phantranthehuy/NIBP-monitor-oscillometric-using-STM32/Docs/Project_Report/Images/Arterial_Pressure_Waveforms.png

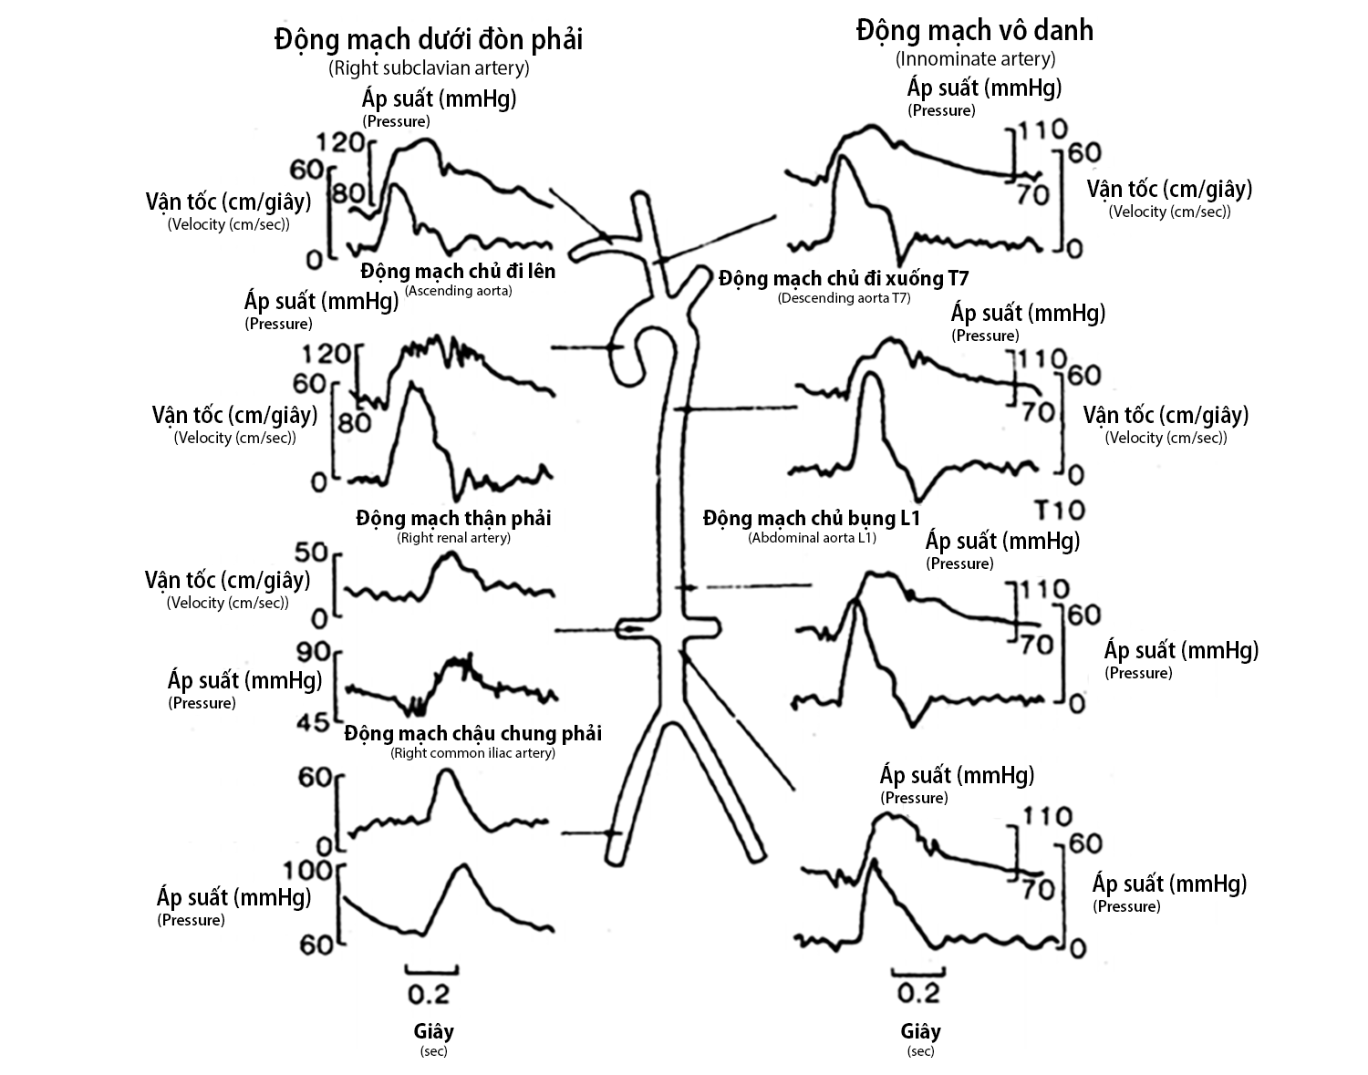
Docs/Project_Report/Images/Arterial_Pressure_Waveforms.png
