phantranthehuy/NIBP-monitor-oscillometric-using-STM32/Docs/Project_Report/Images/Blood_Flow_Velocity_And_Cross_Sectional_Area.png

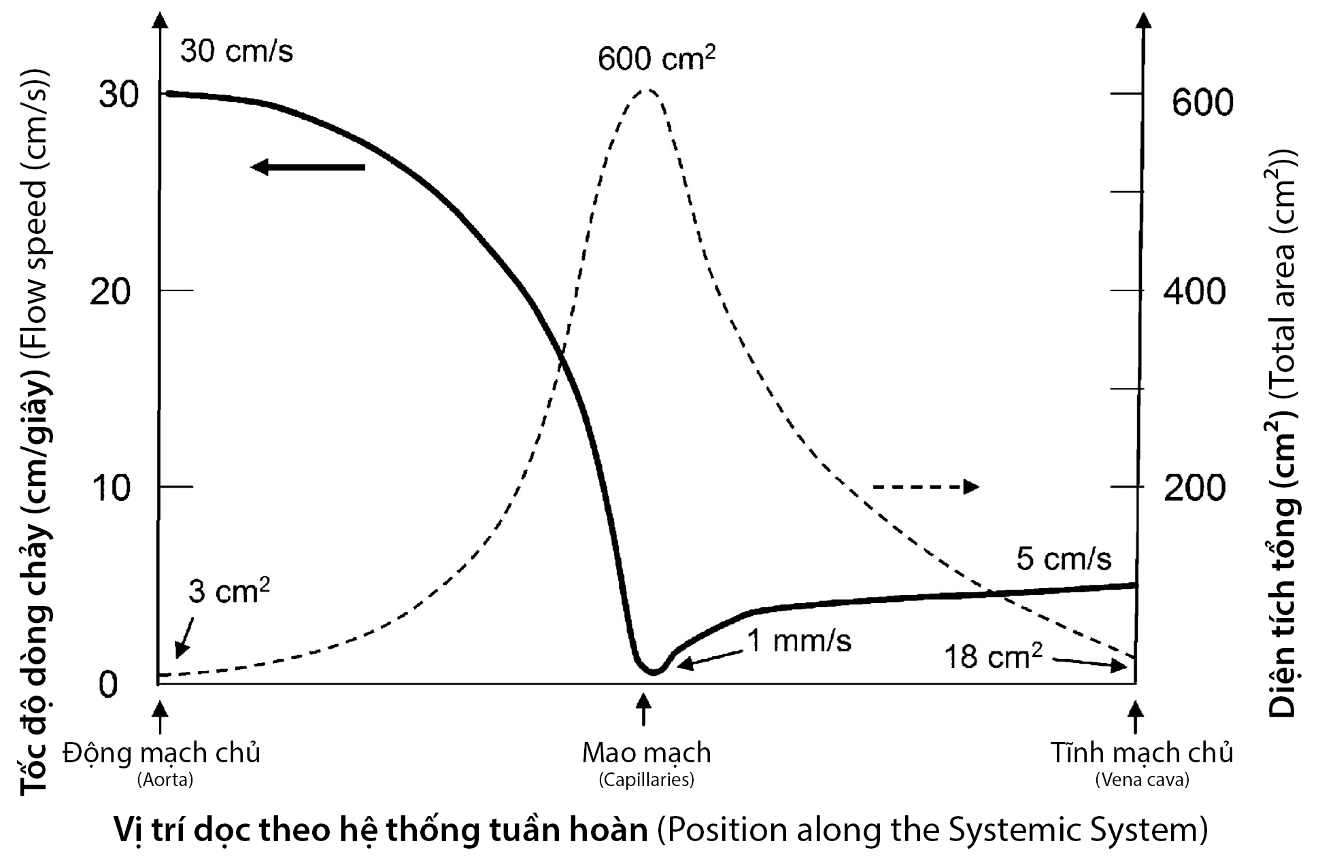
Docs/Project_Report/Images/Blood_Flow_Velocity_And_Cross_Sectional_Area.png
