phantranthehuy/NIBP-monitor-oscillometric-using-STM32/Docs/Project_Report/Images/Circulatory_System_Diagram.png

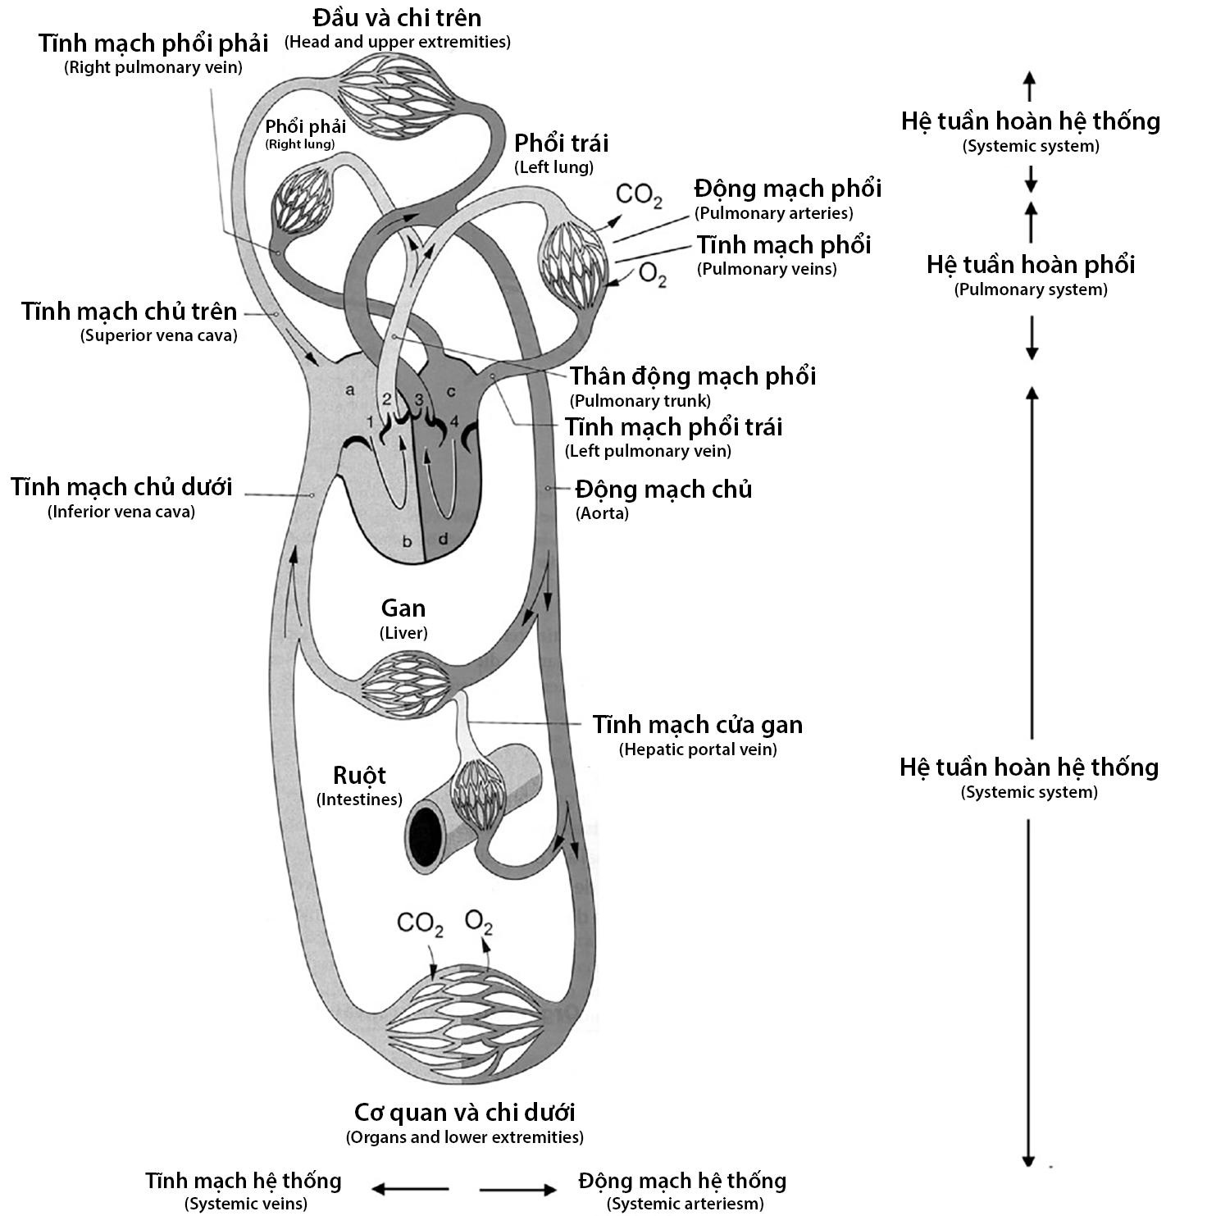
Docs/Project_Report/Images/Circulatory_System_Diagram.png
