phantranthehuy/NIBP-monitor-oscillometric-using-STM32/Docs/Project_Report/Images/Oscillometric_Waveform.png

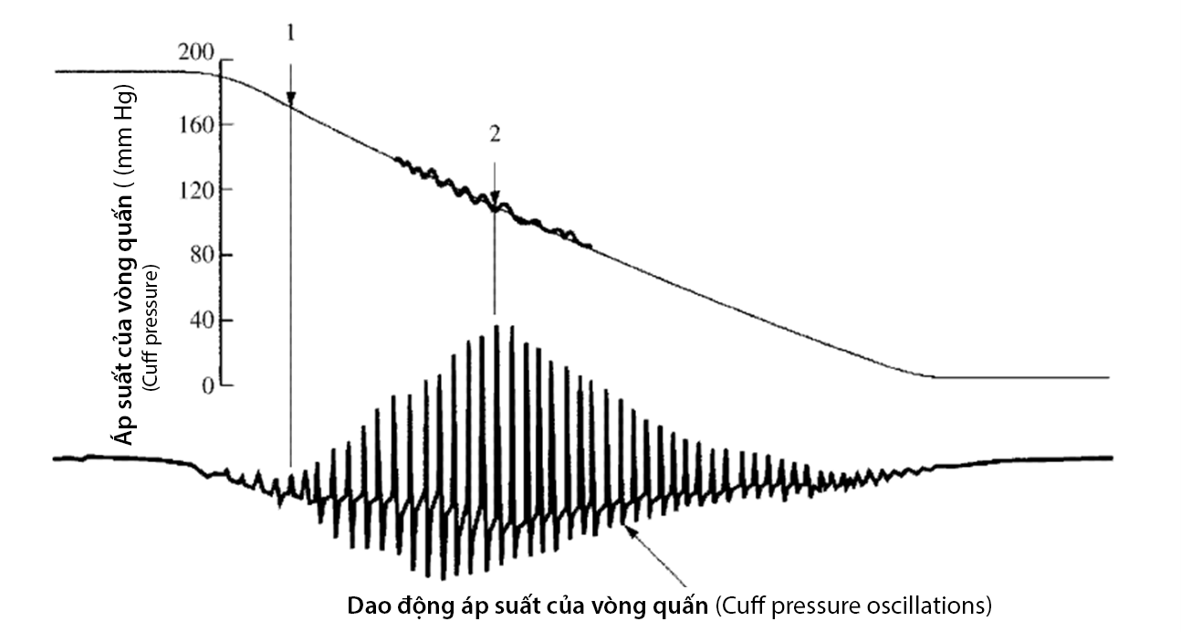
Docs/Project_Report/Images/Oscillometric_Waveform.png
