phantranthehuy/NIBP-monitor-oscillometric-using-STM32/Docs/Project_Report/Images/Venous_Muscle_Pump.png

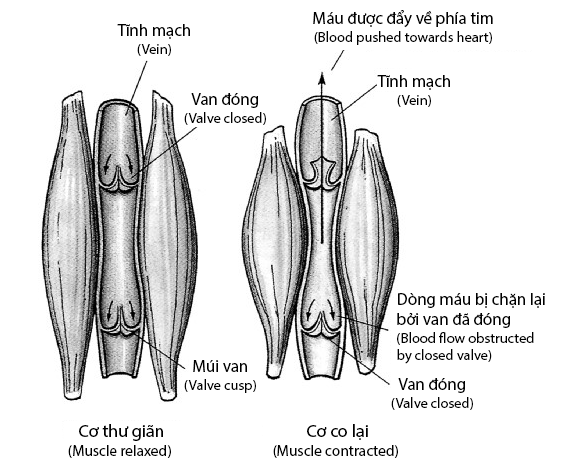
Docs/Project_Report/Images/Venous_Muscle_Pump.png
