phantranthehuy/NIBP-monitor-oscillometric-using-STM32/(list of files, drawings)

Other design files:
Altium/Blood_Pressure_Monitor.PrjPcb
Altium/BPM_Mainboard.PcbDoc
Altium/BPM_Mainboard.SchDoc
