phantranthehuy/NIBP-monitor-oscillometric-using-STM32/Firmware/Core/Src/main.c

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
/* Includes ------------------------------------------------------------------*/
#include "main.h"

ADC_HandleTypeDef hadc1;

I2C_HandleTypeDef hi2c1;

TIM_HandleTypeDef htim2;

/* USER CODE BEGIN PV */
volatile uint8_t timing, timerate, timerun_dias, timecount, timedeflate, timedisplay;
/* USER CODE END PV */

void SystemClock_Config(void);
static void MX_GPIO_Init(void);
static void MX_I2C1_Init(void);
static void MX_ADC1_Init(void);
static void MX_TIM2_Init(void);
/**
  * @brief  The application entry point.
  * @retval int
  */
int main(void)
{
  /* USER CODE BEGIN 1 */
	//define states for Measure control
	//declare variable for motor controls
	uint8_t currentState = 0;
	uint8_t x1, x2 = 0;
	uint8_t timelcd;
	//declare variable for measuring and calculating value
	float DC_gain;
	uint8_t meas_state;
	float  maxpressure, pressure,accum_data, press_data;
	uint8_t count, stop_count;

	//ADC data variables
	float Vref;
	int data;
	float adc_data, former;

	//define counter
	uint8_t sys_count,count_average, countpulse;

	//declare rate measure variable
	float time_pulse,pulse_period, total_pulse_period, pulse_per_min;

	//declare systolic and diastolic variable
	float systolic, diastolic;

	//declare all the threshold values   (giá trị ngưỡng)
	float TH_sys, TH_rate, TH_dias;


  /* USER CODE END 1 */

  /* MCU Configuration--------------------------------------------------------*/

  /* Reset of all peripherals, Initializes the Flash interface and the Systick. */
  HAL_Init();

  /* Configure the system clock */
  SystemClock_Config();

  /* Initialize all configured peripherals */
  MX_GPIO_Init();
  MX_I2C1_Init();
  MX_ADC1_Init();
  MX_TIM2_Init();
  /* USER CODE BEGIN 2 */
  setup(&maxpressure, &meas_state, &former, &TH_sys, &TH_rate,&TH_dias, &time_pulse, &systolic, &diastolic, &total_pulse_period,
  		&pulse_per_min, &sys_count, &count_average,&countpulse, &Vref, &DC_gain, &accum_data, &press_data, &count);
  HAL_ADC_Start(&hadc1);
  HAL_TIM_Base_Start_IT(&htim2);
  /* USER CODE END 2 */

  /* Infinite loop */
  /* USER CODE BEGIN WHILE */
  while (1)
  {
	  switch(currentState)
	      {
	        case startState:
	        	start_state(&sys_count, &pressure, &accum_data, &press_data, &count, &stop_count, &meas_state,
	        		        			&former, &timerun_dias, &time_pulse, &timerate, &timing, &total_pulse_period, &systolic,
	        		        			&diastolic, &pulse_per_min, &count_average, &countpulse, TH_sys, &currentState, &timecount);
	         break;
	        case inflate1State:
	        	inflate1_state(&currentState);
	           break;
	        case inflate2State:
	           inflate2_state();
	           break;
	        case deflateState:
	           deflatestate();
	           break;
	        case displayState:
	           display_state();
	           break;
	        case resetState:
	           reset_state();
	           break;

	     }
    /* USER CODE END WHILE */

    /* USER CODE BEGIN 3 */
  }
  /* USER CODE END 3 */
}

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
/* USER CODE BEGIN 4 */
void HAL_TIM_PeriodElapsedCallback(TIM_HandleTypeDef *htim)
{
	if(HAL_GPIO_ReadPin(GPIOA, GPIO_PIN_7) == GPIO_PIN_RESET)
	{
		x1 = 1;
	}
	if(HAL_GPIO_ReadPin(GPIOA, GPIO_PIN_6) == GPIO_PIN_RESET)
	{
		x1 = 2;
	}
	if(HAL_GPIO_ReadPin(GPIOA, GPIO_PIN_5) == GPIO_PIN_RESET)
	{
		x2 = 1;
	}	//nút stop nhấn, x2 = 1
	timecount++;    // Tăng timecount mỗi lần chạy vòng lặp
	timedeflate++;  // Tăng timedeflate mỗi lần chạy vòng lặp

	// Giảm biến timing mỗi lần qua 1 chu kỳ 40ms
	if(timing > 0) {
		--timing;
	}

	// Cập nhật các biến th�?i gian cho các tác vụ khác

	if(timerate < 6000) {
		++timerate;  // Tăng timerate
	}

	if(timerun_dias < 2000) {
		++timerun_dias;  // Tăng timerun_dias
	}

	if(timedisplay < 2000) {
		++timedisplay;  // Tăng timedisplay
	}
}
/* USER CODE END 4 */
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
